isolenta/bc80/bc80/mmu/mmu.kicad_pcb

## KiCad design bc80/mmu/mmu.kicad_pcb (2023-08-08)

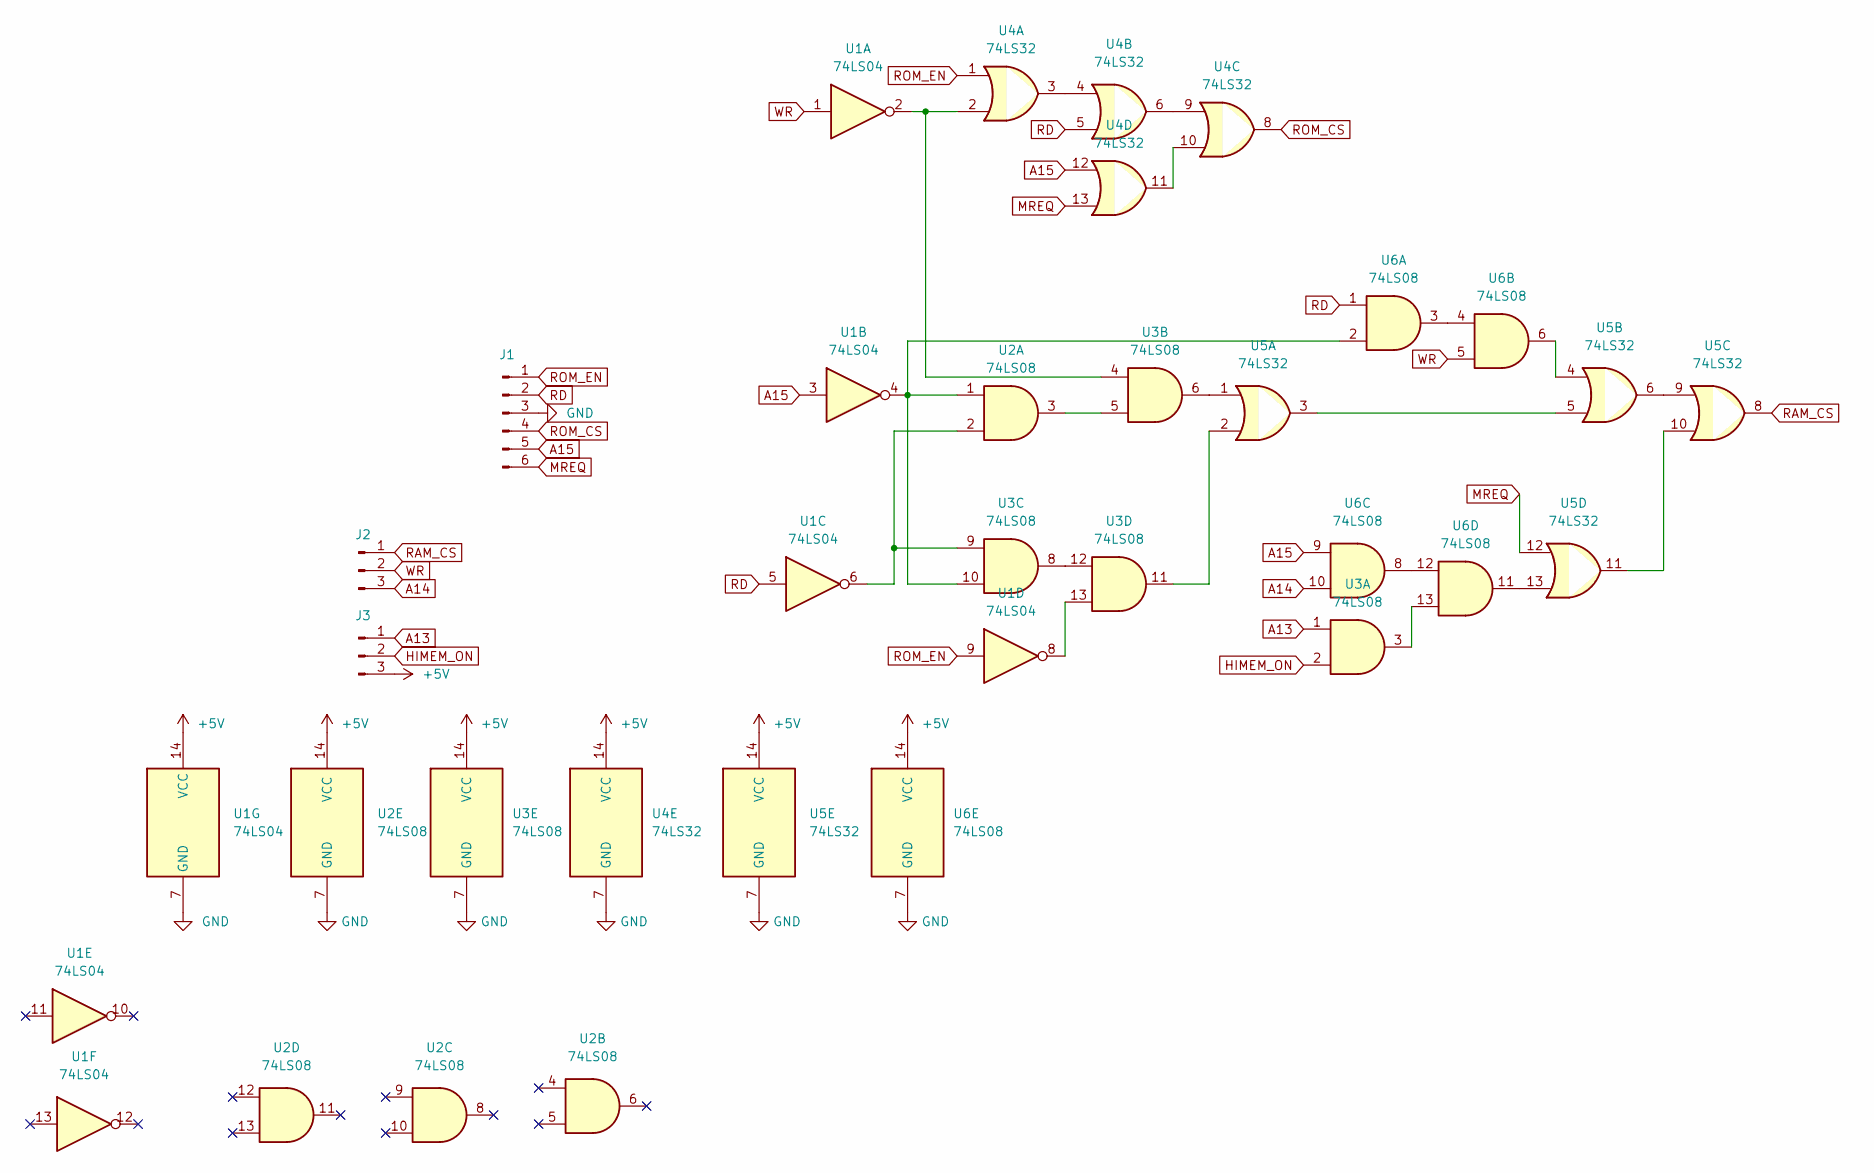
[picture p1: schematic mmu.kicad_sch]

Parts:
J1: Conn_01x06_Male; PinHeader_1x06_P2.54mm_Vertical
J2, J3: Conn_01x03_Male; PinHeader_1x03_P2.54mm_Vertical
U1: 74LS04; DIP-14_W7.62mm_LongPads
U2, U3, U6: 74LS08; DIP-14_W7.62mm_LongPads
U4, U5: 74LS32; DIP-14_W7.62mm_LongPads

Connections:
+5V: J3.3, U1.14 (VCC), U2.14 (VCC), U3.14 (VCC), U4.14 (VCC), U5.14 (VCC), U6.14 (VCC)
A13: J3.1, U3.1
A14: J2.3, U6.10
A15: J1.5, U1.3, U4.12, U6.9
GND: J1.3, U1.7 (GND), U2.7 (GND), U3.7 (GND), U4.7 (GND), U5.7 (GND), U6.7 (GND)
HIMEM_ON: J3.2, U3.2
MREQ: J1.6, U4.13, U5.12
unnamed: U1.2, U3.4, U4.2
unnamed: U1.4, U2.1, U3.10, U6.2
unnamed: U1.6, U2.2, U3.9
unnamed: U1.8, U3.13
unnamed: U2.3, U3.5
unnamed: U3.3, U6.13
unnamed: U3.6, U5.1
unnamed: U3.11, U5.2
unnamed: U3.8, U3.12
unnamed: U4.3, U4.4
unnamed: U4.6, U4.9
unnamed: U4.10, U4.11
unnamed: U5.3, U5.5
unnamed: U5.4, U6.6
unnamed: U5.6, U5.9
unnamed: U5.10, U5.11
unnamed: U5.13, U6.11
unnamed: U6.3, U6.4
unnamed: U6.8, U6.12
RAM_CS: J2.1, U5.8
RD: J1.2, U1.5, U4.5, U6.1
ROM_CS: J1.4, U4.8
ROM_EN: J1.1, U1.9, U4.1
WR: J2.2, U1.1, U6.5

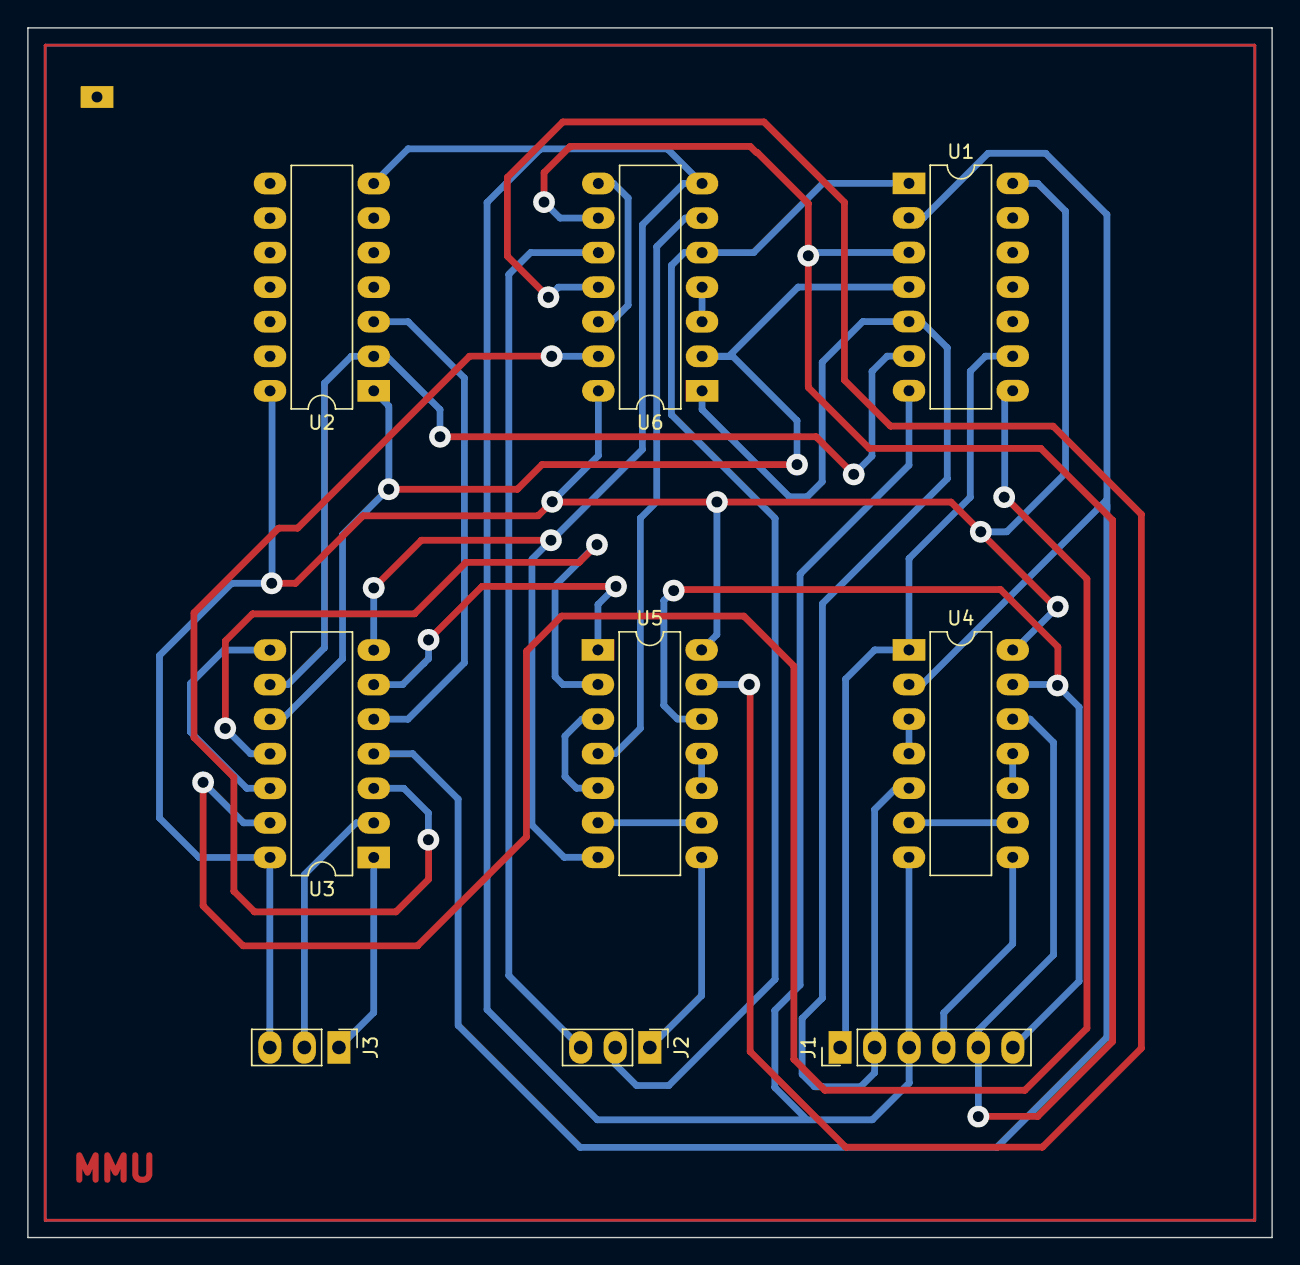
[picture p2: board mmu.kicad_pcb from above]

Board: 2 copper layers, 91.4 x 88.9 mm, 9 parts (0 on the bottom side), 31 nets.
