isolenta/bc80/bc80/bc80.kicad_pcb

## KiCad design bc80/bc80.kicad_pcb (2023-06-14)

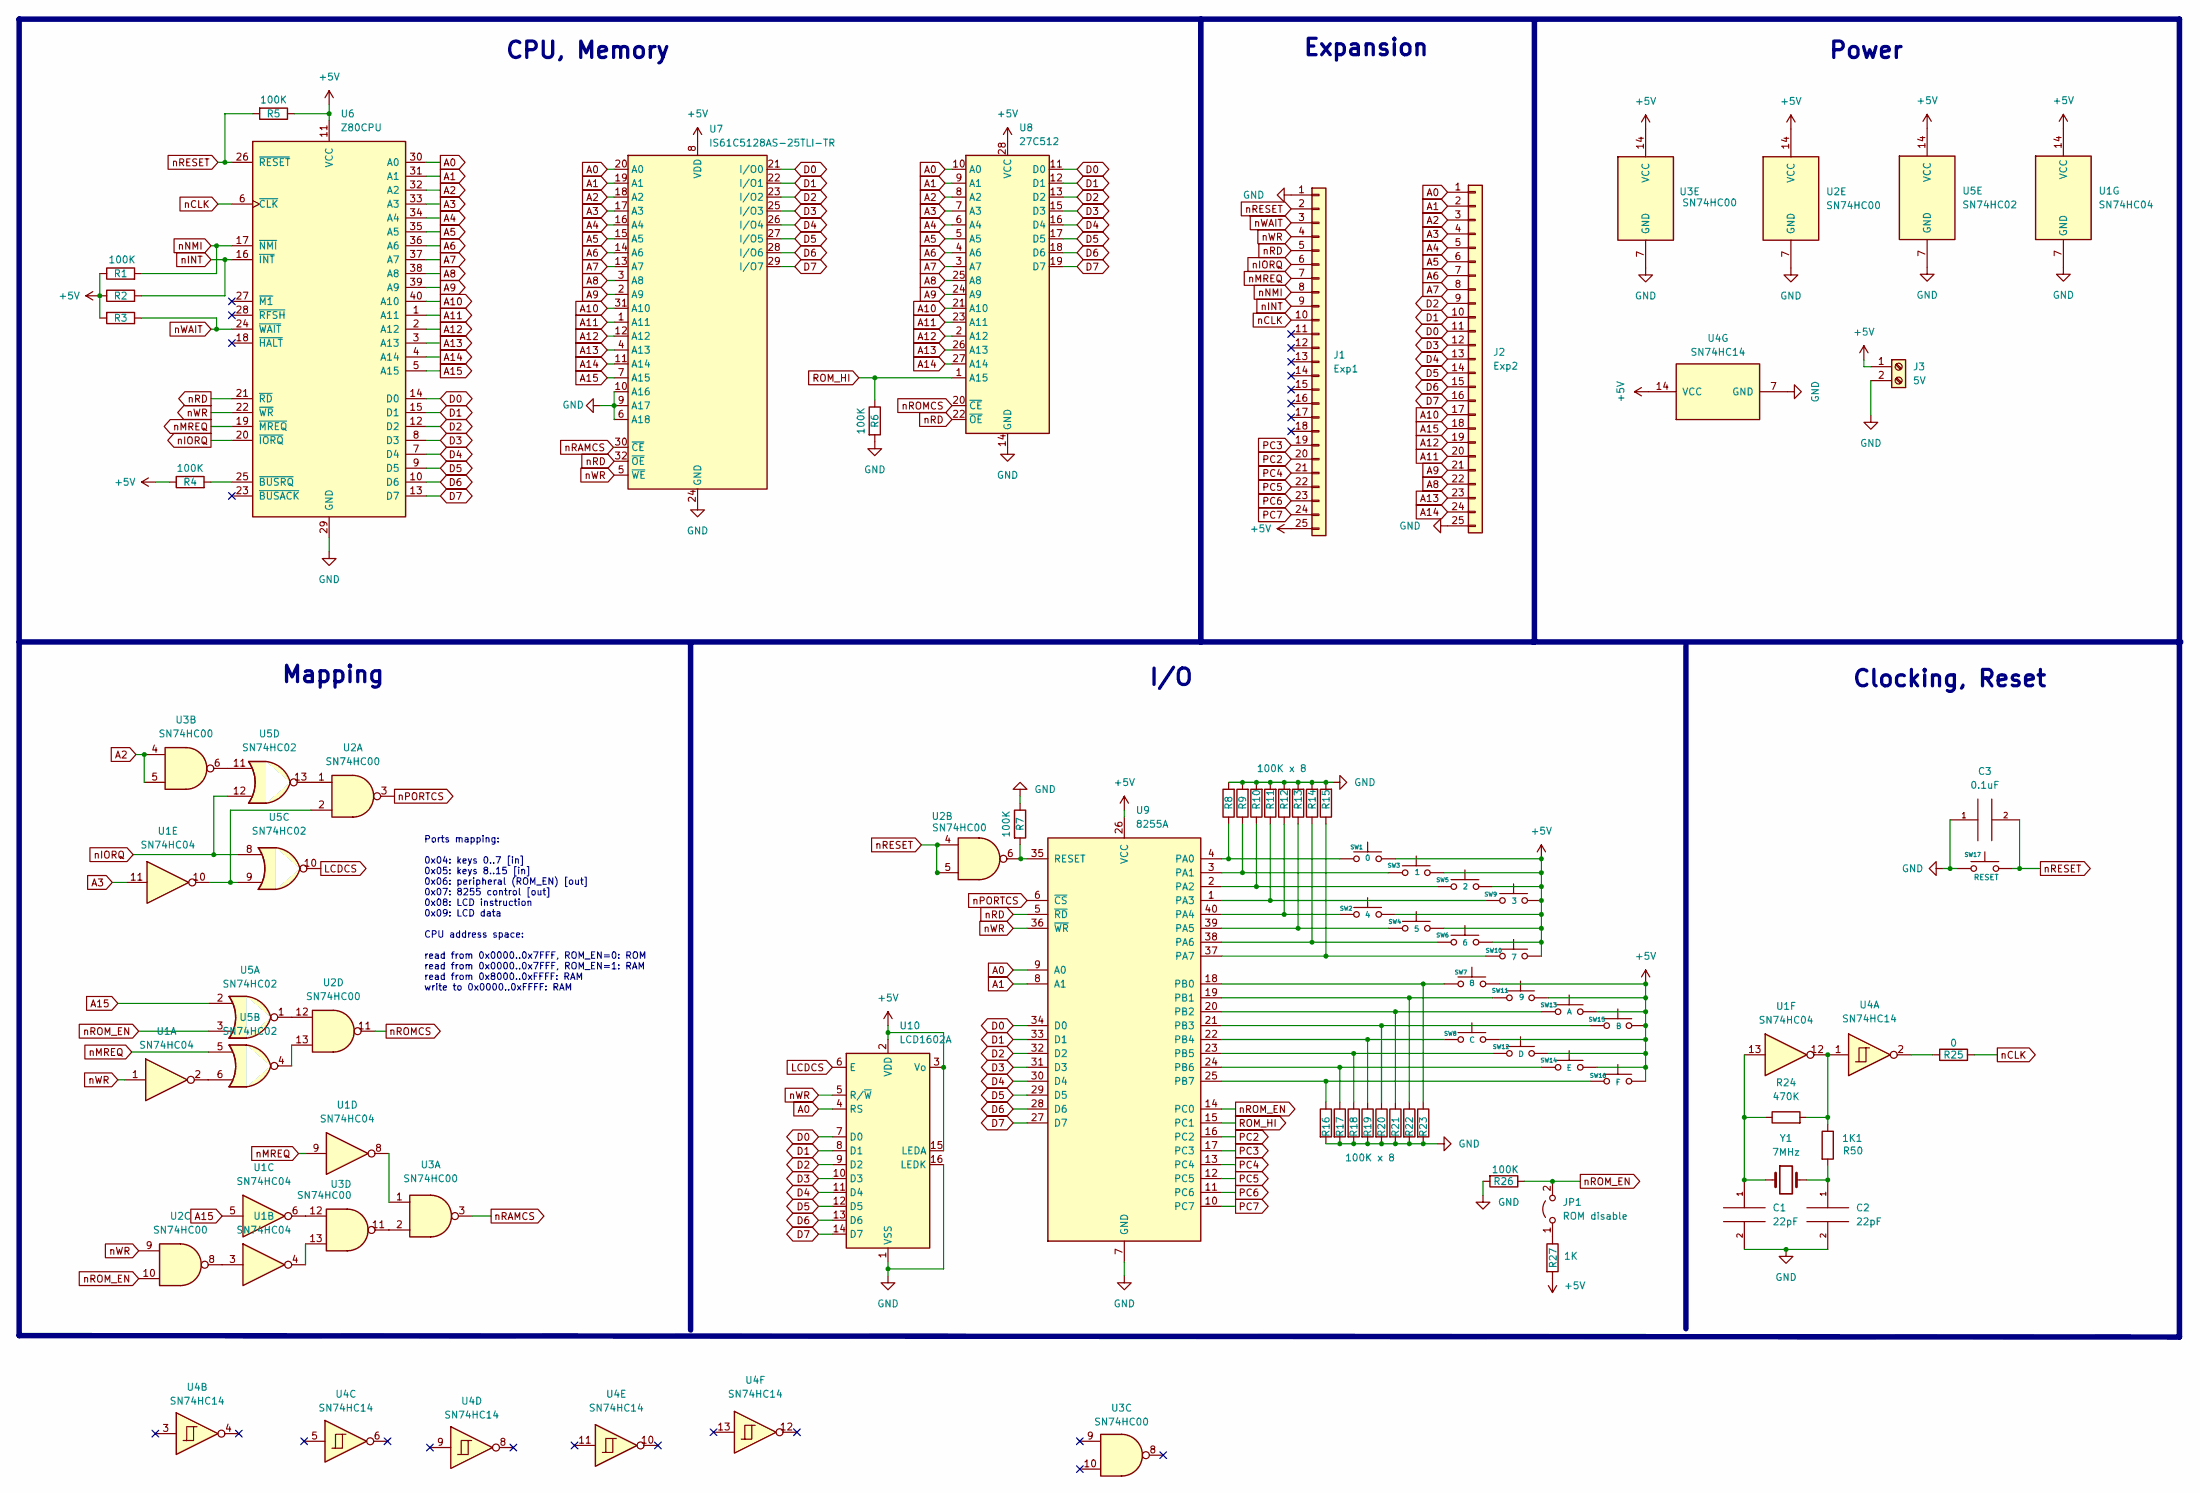
[picture p3: schematic bc80.kicad_sch]

Parts:
1K1: R50; R_0805_2012Metric
C1, C2: 22pF; C_0805_2012Metric
C3: 0.1uF; C_0805_2012Metric
J1: Exp1; PinHeader_1x25_P2.54mm_Vertical
J2: Exp2; PinHeader_1x25_P2.54mm_Vertical
J3: 5V; TerminalBlock_Altech_AK300-2_P5.00mm
JP1: ROM disable; PinHeader_1x02_P2.00mm_Vertical
R1, R2, R3, R4, R5, R6, R7, R9, R10, R11, R12, R13, R14, R15, R16, R17, R18, R19, R20, R21, R22, R26: 100K; R_0805_2012Metric
R8, R23: 100K x 8; R_0805_2012Metric
R24: 470K; R_0805_2012Metric
R25: 0; R_0805_2012Metric
R27: 1K; R_0805_2012Metric
SW1: 0; SW_Push_1P1T_NO_6x6mm_H9.5mm
SW2: 4; SW_Push_1P1T_NO_6x6mm_H9.5mm
SW3: 1; SW_Push_1P1T_NO_6x6mm_H9.5mm
SW4: 5; SW_Push_1P1T_NO_6x6mm_H9.5mm
SW5: 2; SW_Push_1P1T_NO_6x6mm_H9.5mm
SW6: 6; SW_Push_1P1T_NO_6x6mm_H9.5mm
SW7: 8; SW_Push_1P1T_NO_6x6mm_H9.5mm
SW8: C; SW_Push_1P1T_NO_6x6mm_H9.5mm
SW9: 3; SW_Push_1P1T_NO_6x6mm_H9.5mm
SW10: 7; SW_Push_1P1T_NO_6x6mm_H9.5mm
SW11: 9; SW_Push_1P1T_NO_6x6mm_H9.5mm
SW12: D; SW_Push_1P1T_NO_6x6mm_H9.5mm
SW13: A; SW_Push_1P1T_NO_6x6mm_H9.5mm
SW14: E; SW_Push_1P1T_NO_6x6mm_H9.5mm
SW15: B; SW_Push_1P1T_NO_6x6mm_H9.5mm
SW16: F; SW_Push_1P1T_NO_6x6mm_H9.5mm
SW17: RESET; SW_Push_1P1T_NO_6x6mm_H9.5mm
U1: SN74HC04; DIP-14_W7.62mm
U2, U3: SN74HC00; DIP-14_W7.62mm
U4: SN74HC14; DIP-14_W7.62mm
U5: SN74HC02; DIP-14_W7.62mm
U6: Z80CPU; DIP-40_W15.24mm
U7: IS61C5128AS-25TLI-TR; TSOP-I-32_18.4x8mm_P0.5mm
U8: 27C512; DIP-28_W15.24mm
U9: 8255A; DIP-40_W15.24mm
U10: LCD1602A; WC1602A
Y1: 7MHz; Crystal_HC49-U_Vertical

Connections:
+5V: J1.25, J3.1, R1.1, R2.1, R3.2, R4.1, R5.1, R27.2, SW1.2, SW2.2, SW3.2, SW4.2, SW5.2, SW6.2, SW7.2, SW8.2, SW9.2, SW10.2, SW11.2, SW12.2, SW13.2, SW14.2, SW15.2, SW16.2, U1.14 (VCC), U2.14 (VCC), U3.14 (VCC), U4.14 (VCC), U5.14 (VCC), U6.11 (VCC), U7.8 (VDD), U8.28 (VCC), U9.26 (VCC), U10.2 (VDD), U10.3 (Vo), U10.15 (LEDA)
A0: J2.1, U6.30 (A0), U7.20 (A0), U8.10 (A0), U9.9 (A0), U10.4 (RS)
A1: J2.2, U6.31 (A1), U7.19 (A1), U8.9 (A1), U9.8 (A1)
A2: J2.3, U3.4, U3.5, U6.32 (A2), U7.18 (A2), U8.8 (A2)
A3: J2.4, U1.11, U6.33 (A3), U7.17 (A3), U8.7 (A3)
A4: J2.5, U6.34 (A4), U7.16 (A4), U8.6 (A4)
A5: J2.6, U6.35 (A5), U7.15 (A5), U8.5 (A5)
A6: J2.7, U6.36 (A6), U7.14 (A6), U8.4 (A6)
A7: J2.8, U6.37 (A7), U7.13 (A7), U8.3 (A7)
A8: J2.22, U6.38 (A8), U7.3 (A8), U8.25 (A8)
A9: J2.21, U6.39 (A9), U7.2 (A9), U8.24 (A9)
A10: J2.17, U6.40 (A10), U7.31 (A10), U8.21 (A10)
A11: J2.20, U6.1 (A11), U7.1 (A11), U8.23 (A11)
A12: J2.19, U6.2 (A12), U7.12 (A12), U8.2 (A12)
A13: J2.23, U6.3 (A13), U7.4 (A13), U8.26 (A13)
A14: J2.24, U6.4 (A14), U7.11 (A14), U8.27 (A14)
A15: J2.18, U1.5, U5.2, U6.5 (A15), U7.7 (A15)
D0: J2.11, U6.14 (D0), U7.21 (I/O0), U8.11 (D0), U9.34 (D0), U10.7 (D0)
D1: J2.10, U6.15 (D1), U7.22 (I/O1), U8.12 (D1), U9.33 (D1), U10.8 (D1)
D2: J2.9, U6.12 (D2), U7.23 (I/O2), U8.13 (D2), U9.32 (D2), U10.9 (D2)
D3: J2.12, U6.8 (D3), U7.25 (I/O3), U8.15 (D3), U9.31 (D3), U10.10 (D3)
D4: J2.13, U6.7 (D4), U7.26 (I/O4), U8.16 (D4), U9.30 (D4), U10.11 (D4)
D5: J2.14, U6.9 (D5), U7.27 (I/O5), U8.17 (D5), U9.29 (D5), U10.12 (D5)
D6: J2.15, U6.10 (D6), U7.28 (I/O6), U8.18 (D6), U9.28 (D6), U10.13 (D6)
D7: J2.16, U6.13 (D7), U7.29 (I/O7), U8.19 (D7), U9.27 (D7), U10.14 (D7)
GND: C1.2, C2.2, C3.1, J1.1, J2.25, J3.2, R6.2, R7.1, R8.2, R9.2, R10.2, R11.2, R12.2, R13.2, R14.2, R15.2, R16.2, R17.2, R18.2, R19.2, R20.2, R21.2, R22.2, R23.2, R26.2, SW17.1, U1.7 (GND), U2.7 (GND), U3.7 (GND), U4.7 (GND), U5.7 (GND), U6.29 (GND), U7.6 (A18), U7.9 (A17), U7.10 (A16), U7.24 (GND), U8.14 (GND), U9.7 (GND), U10.1 (VSS), U10.16 (LEDK)
LCDCS: U5.10, U10.6 (E)
unnamed: 1K1.1, R24.2, U1.12, U4.1
unnamed: 1K1.2, C2.1, Y1.2
unnamed: C1.1, R24.1, U1.13, Y1.1
unnamed 30: JP1.1 (A), R27.1; also elsewhere on the board
unnamed: R4.2, U6.25 (~BUSRQ)
unnamed: R7.2, U2.6, U9.35 (RESET)
unnamed: R8.1, SW1.1, U9.4 (PA0)
unnamed: R9.1, SW3.1, U9.3 (PA1)
unnamed: R10.1, SW5.1, U9.2 (PA2)
unnamed: R11.1, SW9.1, U9.1 (PA3)
unnamed: R12.1, SW2.1, U9.40 (PA4)
unnamed: R13.1, SW4.1, U9.39 (PA5)
unnamed: R14.1, SW6.1, U9.38 (PA6)
unnamed: R15.1, SW10.1, U9.37 (PA7)
unnamed: R16.1, SW16.1, U9.25 (PB7)
unnamed: R17.1, SW14.1, U9.24 (PB6)
unnamed: R18.1, SW12.1, U9.23 (PB5)
unnamed: R19.1, SW8.1, U9.22 (PB4)
unnamed: R20.1, SW15.1, U9.21 (PB3)
unnamed: R21.1, SW13.1, U9.20 (PB2)
unnamed: R22.1, SW11.1, U9.19 (PB1)
unnamed: R23.1, SW7.1, U9.18 (PB0)
unnamed: R25.1, U4.2
unnamed: U1.2, U5.6
unnamed: U1.3, U2.8
unnamed: U1.4, U3.13
unnamed: U1.6, U3.12
unnamed: U1.8, U3.1
unnamed: U1.10, U2.2, U5.9
unnamed: U2.1, U5.13
unnamed: U2.12, U5.1
unnamed: U2.13, U5.4
unnamed: U3.6, U5.11
unnamed: U3.2, U3.11
PC2: J1.20, U9.16 (PC2)
PC3: J1.19, U9.17 (PC3)
PC4: J1.21, U9.13 (PC4)
PC5: J1.22, U9.12 (PC5)
PC6: J1.23, U9.11 (PC6)
PC7: J1.24, U9.10 (PC7)
ROM_HI: R6.1, U8.1 (A15), U9.15 (PC1)
nCLK: J1.10, R25.2, U6.6 (~CLK)
nINT: J1.9, R2.2, U6.16 (~INT)
nIORQ: J1.6, U5.8, U5.12, U6.20 (~IORQ)
nMREQ: J1.7, U1.9, U5.5, U6.19 (~MREQ)
nNMI: J1.8, R1.2, U6.17 (~NMI)
nPORTCS: U2.3, U9.6 (~CS)
nRAMCS: U3.3, U7.30 (~CE)
nRD: J1.5, U6.21 (~RD), U7.32 (~OE), U8.22 (~OE), U9.5 (~RD)
nRESET: C3.2, J1.2, R5.2, SW17.2, U6.26 (~RESET)
nROMCS: U2.11, U8.20 (~CE)
nROM_EN: JP1.2 (B), R26.1, U2.10, U5.3, U9.14 (PC0); also elsewhere on the board
nWAIT: J1.3, R3.1, U6.24 (~WAIT)
nWR: J1.4, U1.1, U2.9, U6.22 (~WR), U7.5 (~WE), U9.36 (~WR), U10.5 (R/~W)

Notes on the sheet:
Mapping
Expansion
I/O
Clocking, Reset
Power
CPU, Memory
Ports mapping: 0x04: keys 0..7 [in] 0x05: keys 8..15 [in] 0x06: peripheral (ROM_EN) [out] 0x07: 8255 control [out] 0x08: LCD instruction 0x09: LCD data CPU address space: read from 0x0000..0x7FFF, ROM_EN=0: ROM read from 0x0000..0x7FFF, ROM_EN=1: RAM read from 0x8000..0xFFFF: RAM write to 0x0000..0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

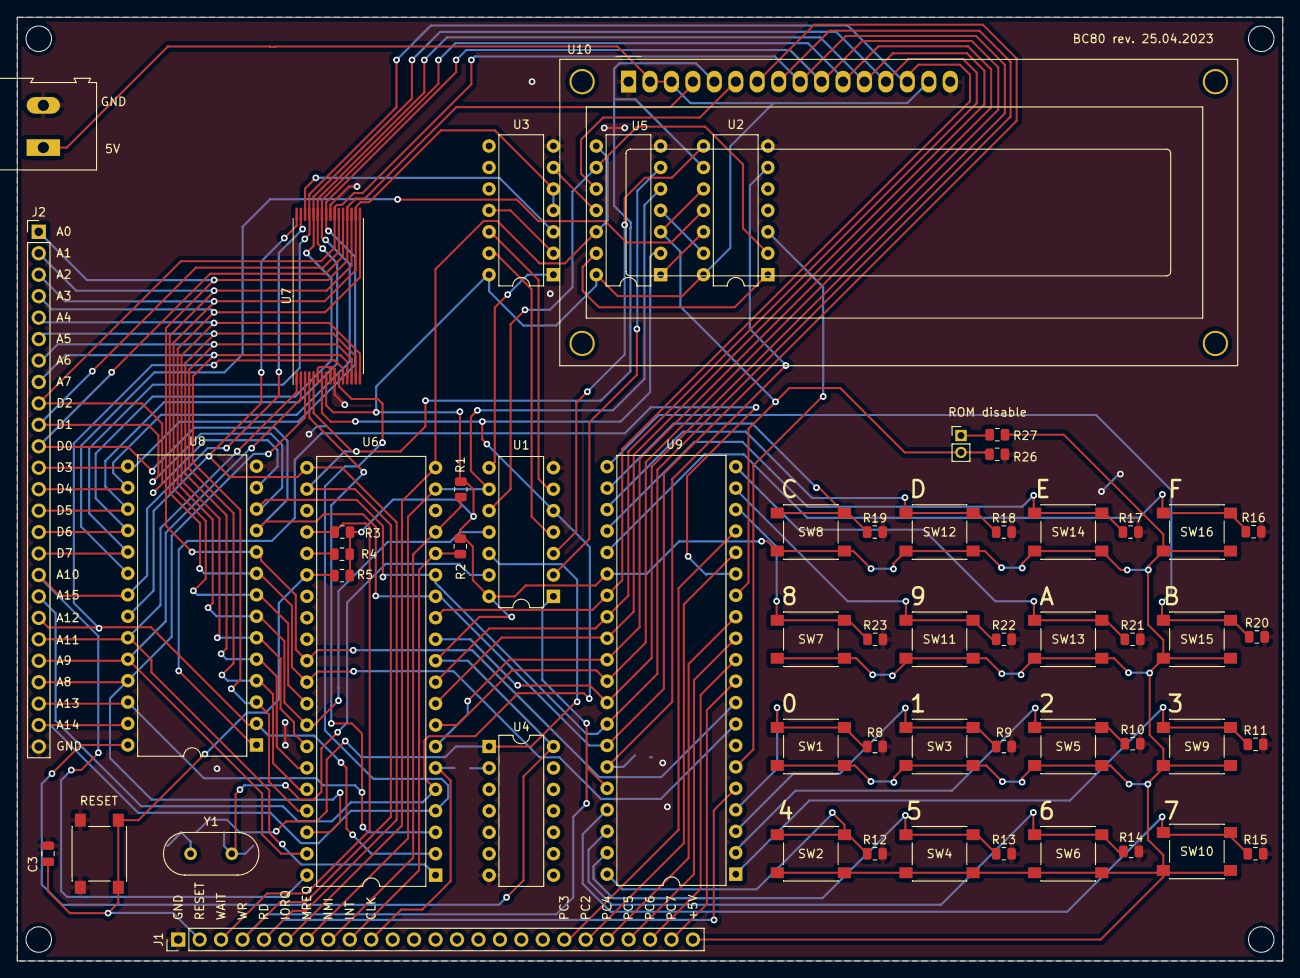
[picture p4: board bc80.kicad_pcb from above]

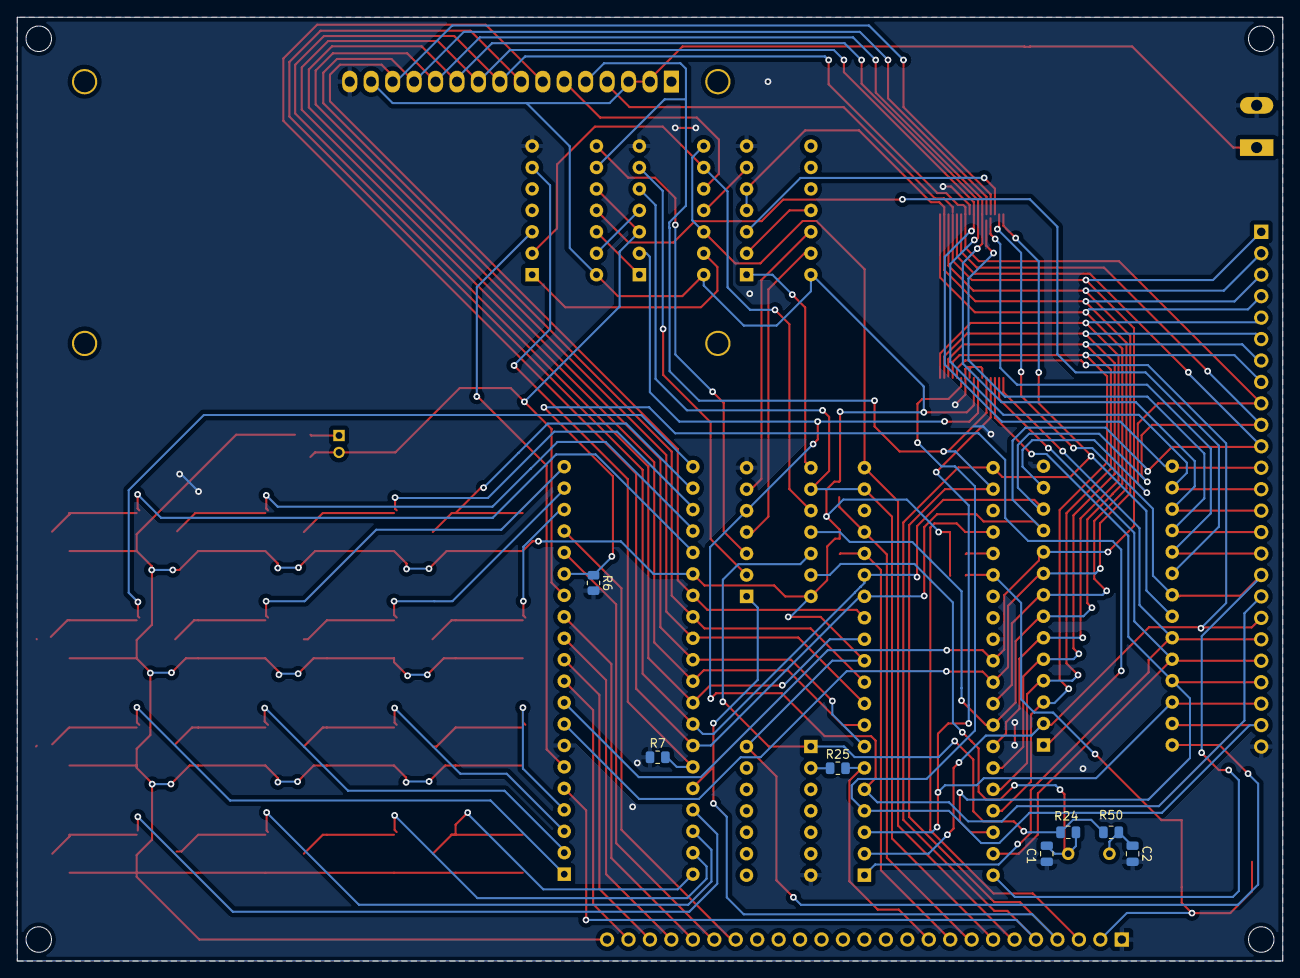
[picture p5: board bc80.kicad_pcb from below]

Board: 2 copper layers, 149.9 x 111.8 mm, 63 parts (7 on the bottom side), 81 nets.

Other parts of the board:
ROM disable: ROM disable; PinHeader_1x02_P2.00mm_Vertical

Their connections:
unnamed 30: ROM disable.1 (A); also elsewhere on the board
nROM_EN: ROM disable.2 (B); also elsewhere on the board
