isolenta/bc80/(commit log)

2023-06-14 add kicad projects
    [bc80.kicad_pcb, bc80.kicad_sch, mmu.kicad_pcb, mmu.kicad_sch]
2023-06-19 implement ELF target backend and on the fly section switching
2023-06-24 wrap assembler/disassembler into library with stateless API
2023-08-08 a few fixes in MMU schematics and layout
    [mmu.kicad_pcb, mmu.kicad_sch]
2023-08-08 add bluepill application for MMU board debugging
2025-01-12 rcc: introduce preprocessor stage
2025-02-16 disas: print num cycles per instruction
